Ldoppea/enlarger-electronic-timer/electronic/README.md

# Electronic for enlarger-electronic-timer

## Resources

Arduino Mini library downloaded from http://kicadhowto.org/LibLib.htm
