Ldoppea/enlarger-electronic-timer/mechanic/boxing.SLDASM

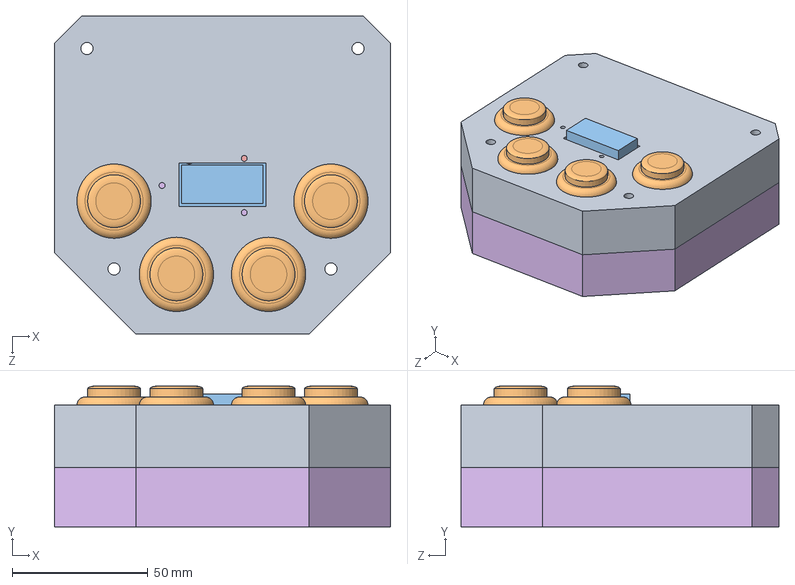
[picture p1: CAD file, 2019-05-01]
mechanic/boxing.SLDASM
124.0 x 52.0 x 117.3 mm
boxing-top
ArcadeButton^boxing x 4
GrouveDisplay^boxing
GrouveRelay^boxing
Timer^boxing
boxing-bottom
