Ldoppea/enlarger-electronic-timer/mechanic/boxing-top.sldprt

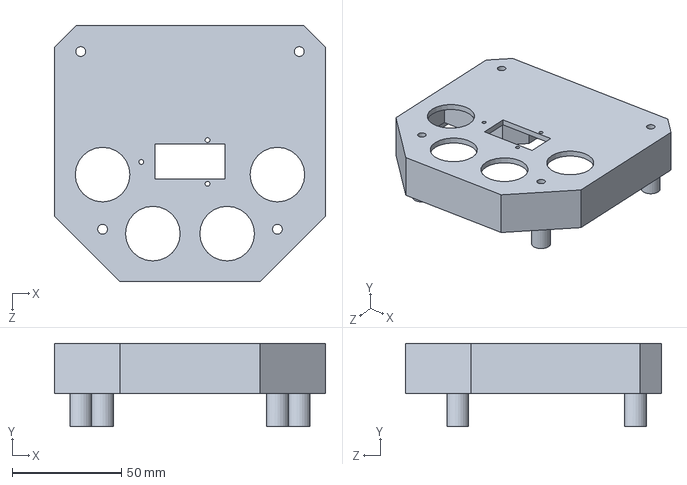
[picture p2: CAD file, 2019-05-01]
mechanic/boxing-top.sldprt
124.0 x 38.0 x 117.3 mm
