Ldoppea/enlarger-electronic-timer/mechanic/boxing-bottom.sldprt

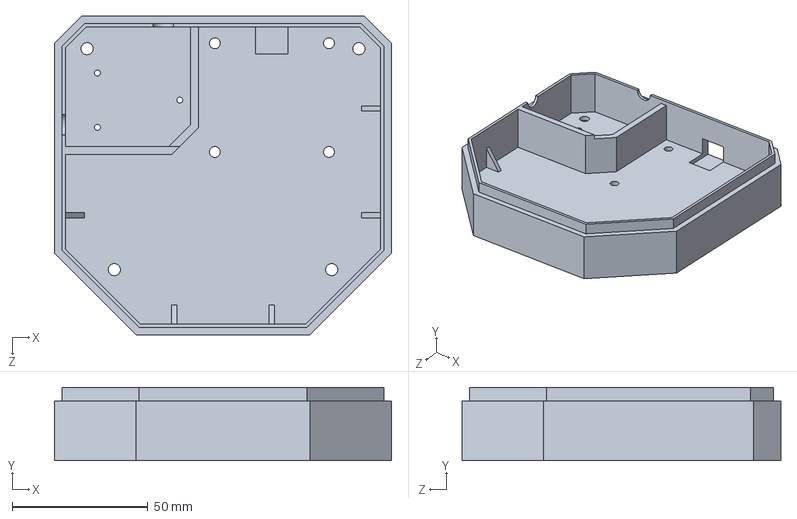
[picture p3: CAD file, 2019-05-01]
mechanic/boxing-bottom.sldprt
124.0 x 27.0 x 117.3 mm
