Ldoppea/enlarger-electronic-timer/electronic/gerber/pdf/enlarger-electronic-timer-B.Cu.pdf

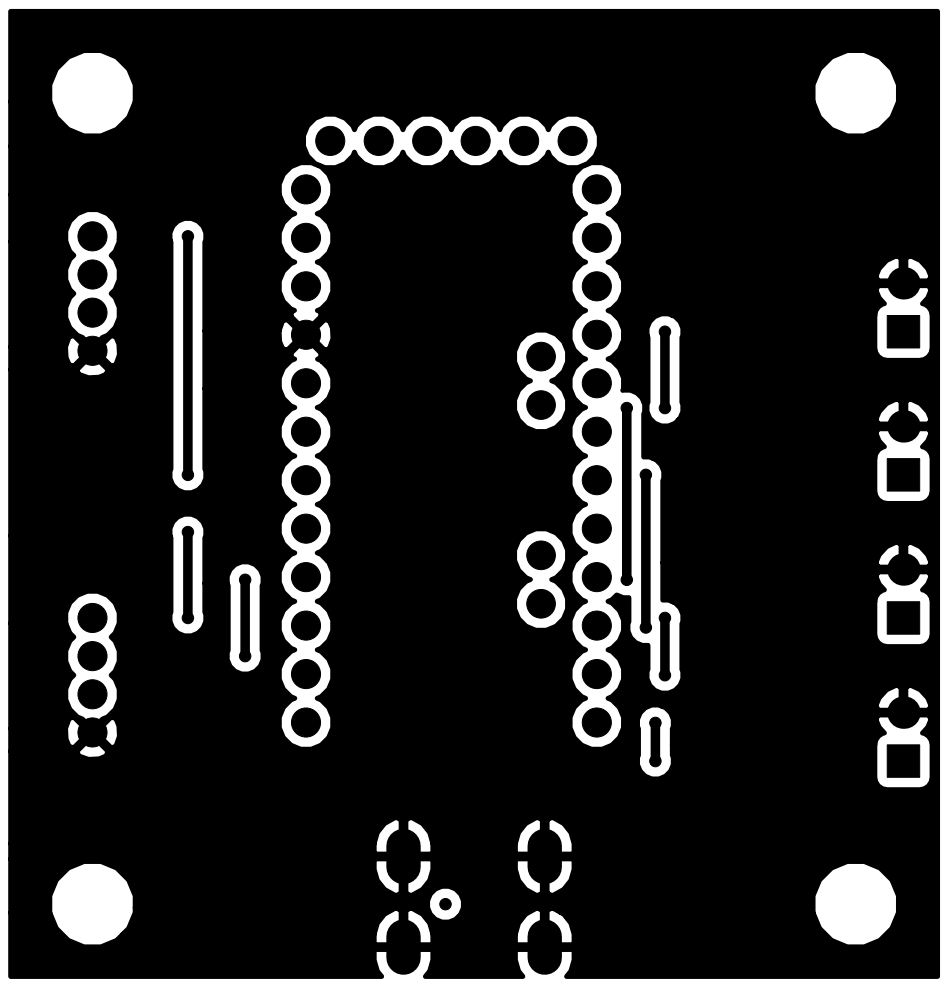
[picture p4: page 1]
