Ldoppea/enlarger-electronic-timer/electronic/gerber/pdf/enlarger-electronic-timer-B.Mask.pdf

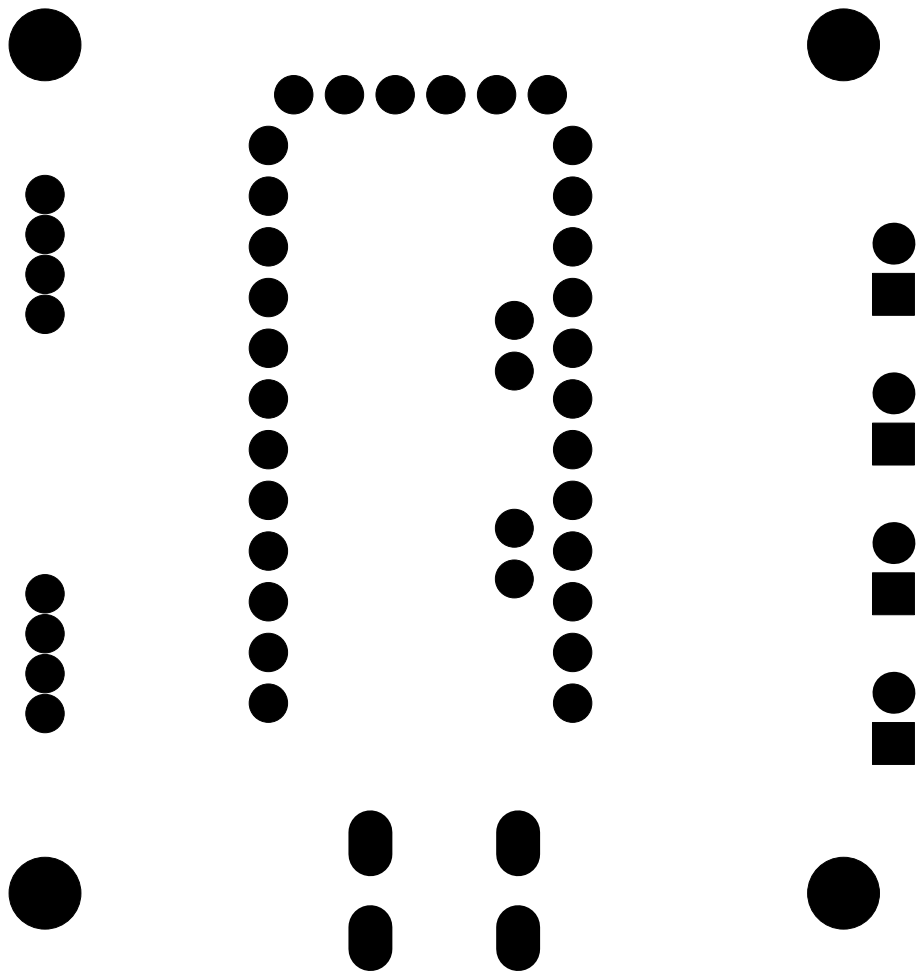
[picture p5: page 1]
