Ldoppea/enlarger-electronic-timer/electronic/gerber/pdf/enlarger-electronic-timer-F.Cu.pdf

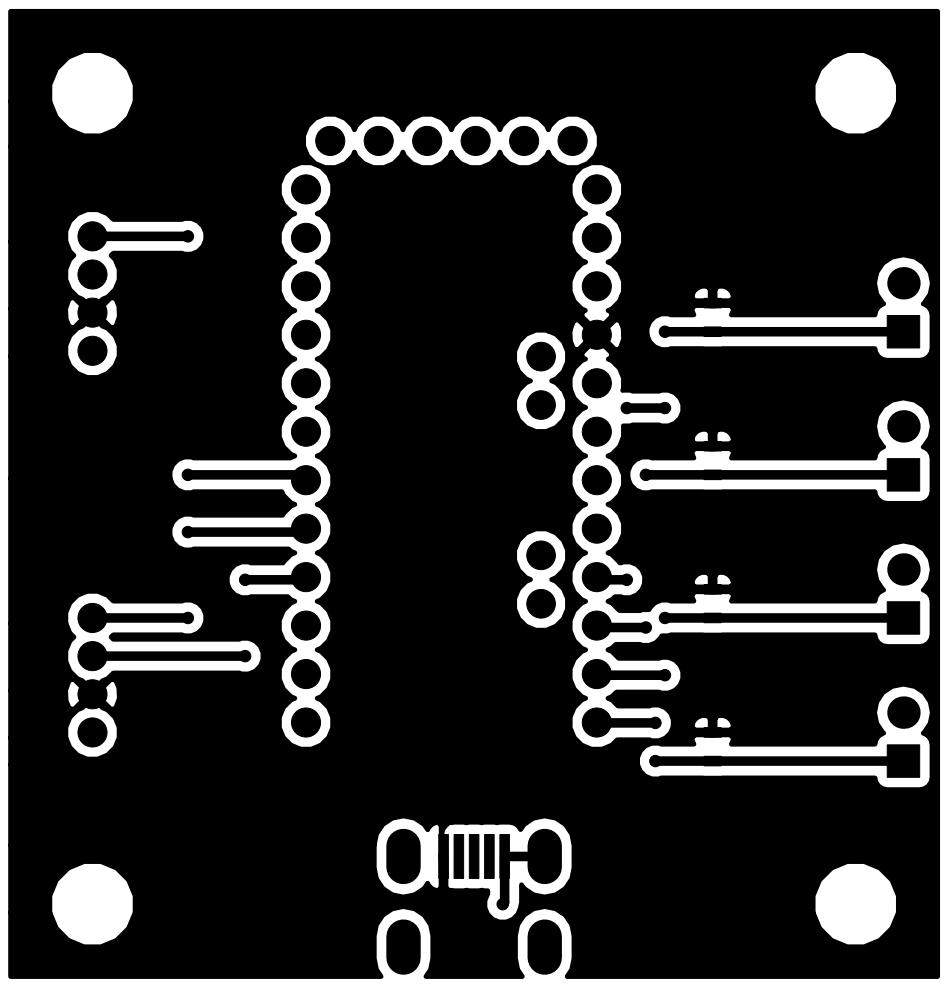
[picture p6: page 1]
