Ldoppea/enlarger-electronic-timer/electronic/gerber/pdf/enlarger-electronic-timer-F.Mask.pdf

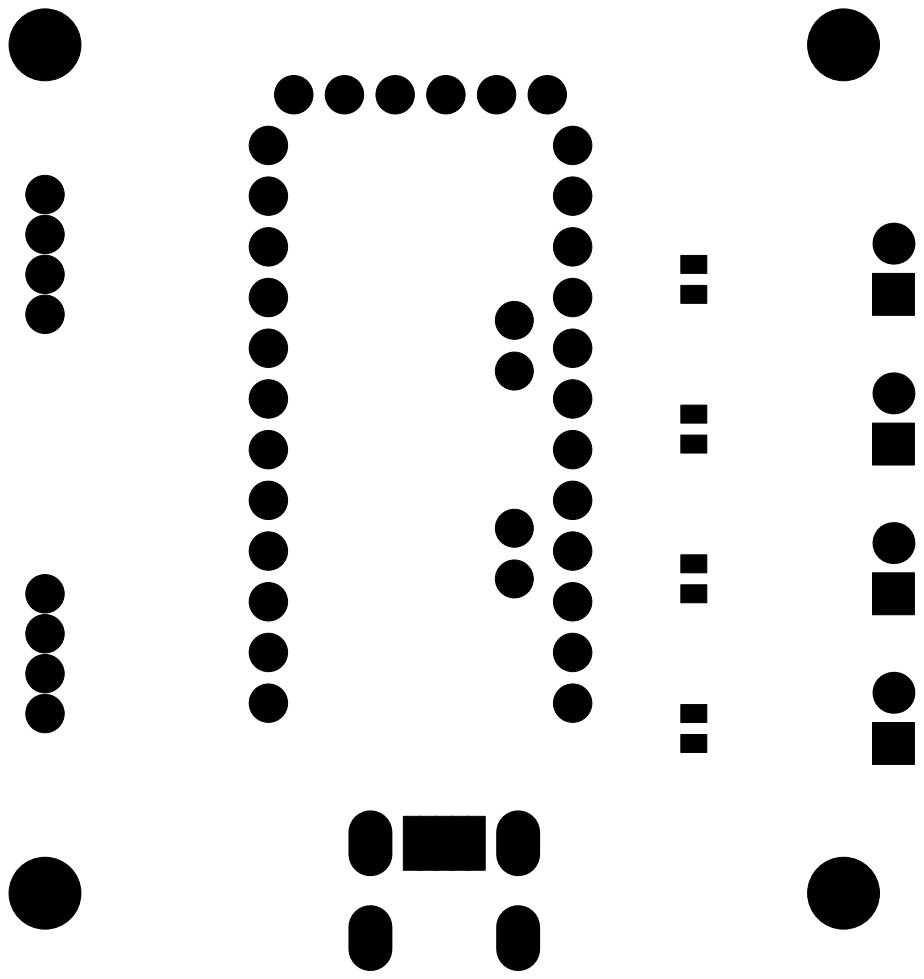
[picture p7: page 1]
