Ldoppea/enlarger-electronic-timer/electronic/gerber/pdf/enlarger-electronic-timer-F.SilkS.pdf

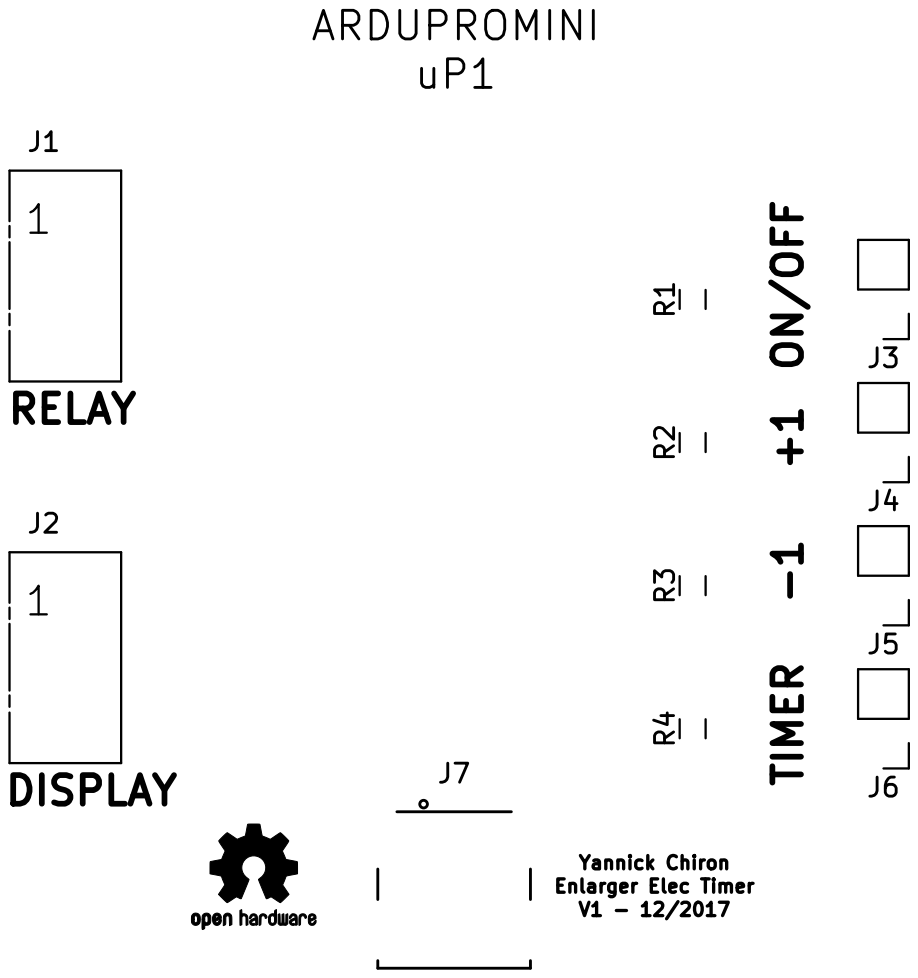
[picture p8: page 1]
