Ldoppea/enlarger-electronic-timer/electronic/enlarger-electronic-timer.kicad_pcb

## KiCad design electronic/enlarger-electronic-timer.kicad_pcb (2017-12-17)

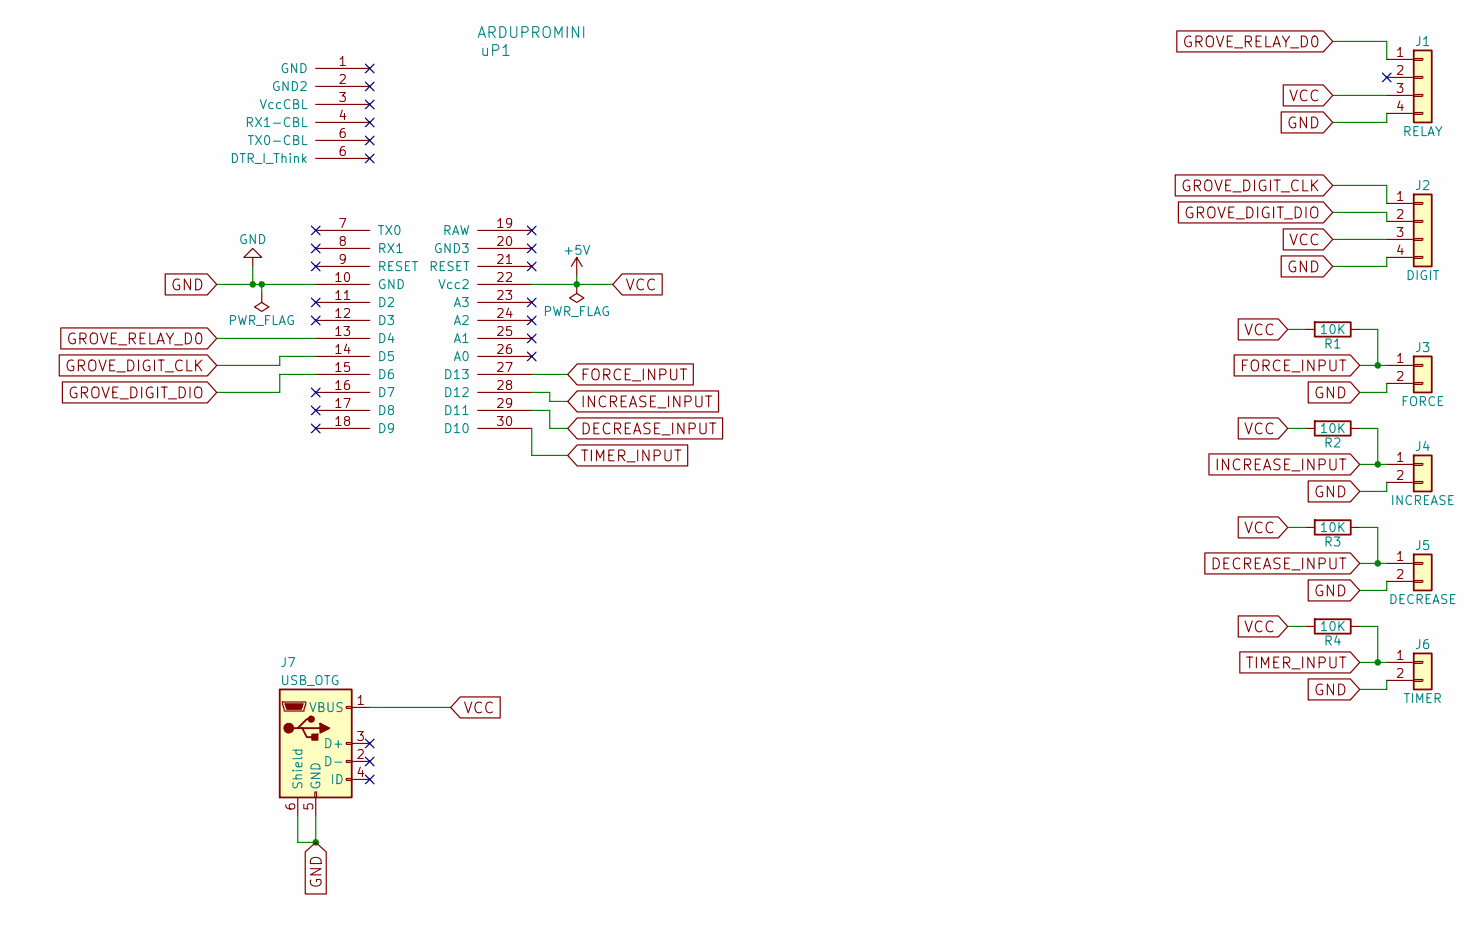
[picture p9: schematic enlarger-electronic-timer.sch]

Parts:
J1: RELAY; Grove_1x04
J2: DIGIT; Grove_1x04
J3: FORCE; Pin_Header_Straight_1x02_Pitch2.54mm
J4: INCREASE; Pin_Header_Straight_1x02_Pitch2.54mm
J5: DECREASE; Pin_Header_Straight_1x02_Pitch2.54mm
J6: TIMER; Pin_Header_Straight_1x02_Pitch2.54mm
J7: USB_OTG; ST-USB-013A
R1, R2, R3, R4: 10K; R_0603
uP1: ARDUPROMINI; arduino_mini

Connections:
DECREASE_INPUT: J5.1, R3.1, uP1.29 (D11)
FORCE_INPUT: J3.1, R1.1, uP1.27 (D13)
GND: J1.4, J2.4, J3.2, J4.2, J5.2, J6.2, J7.5 (GND), J7.6 (Shield), uP1.10 (GND)
GROVE_DIGIT_CLK: J2.1, uP1.14 (D5)
GROVE_DIGIT_DIO: J2.2, uP1.15 (D6)
GROVE_RELAY_D0: J1.1, uP1.13 (D4)
INCREASE_INPUT: J4.1, R2.1, uP1.28 (D12)
TIMER_INPUT: J6.1, R4.1, uP1.30 (D10)
VCC: J1.3, J2.3, J7.1 (VBUS), R1.2, R2.2, R3.2, R4.2, uP1.22 (Vcc2)

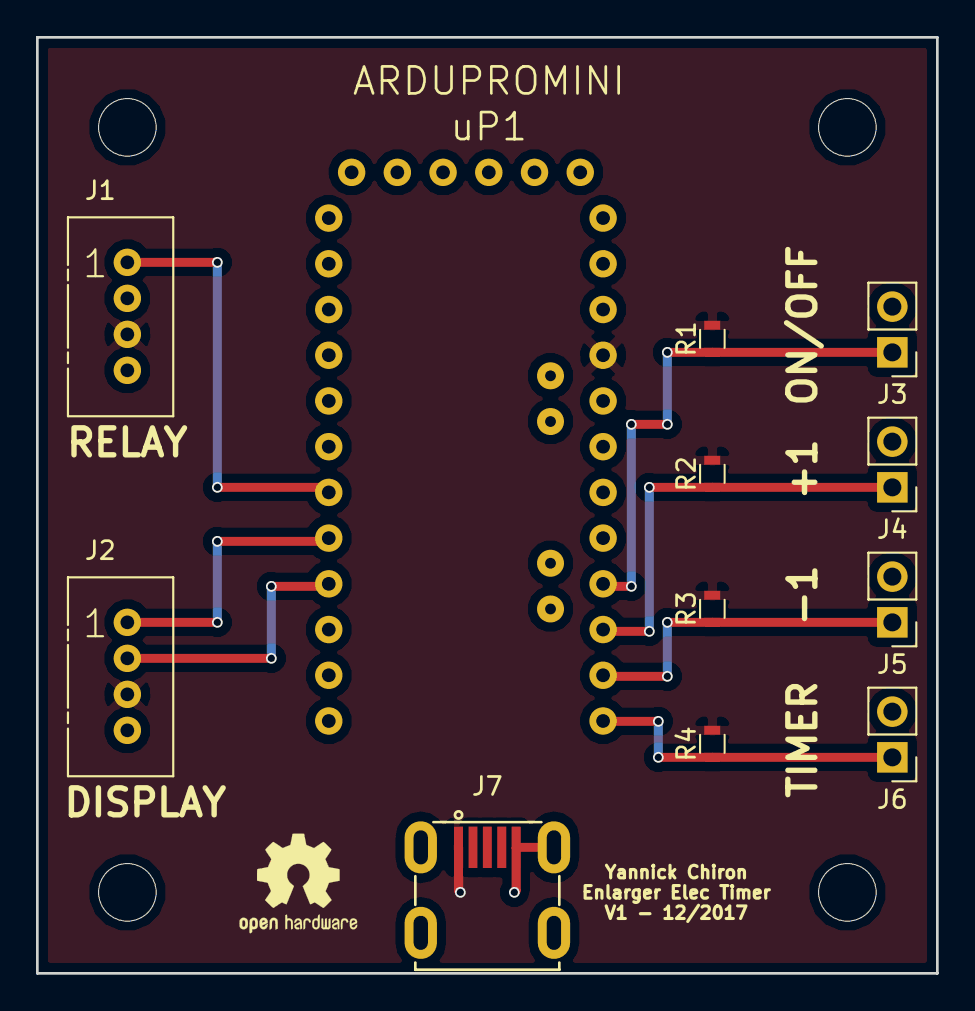
[picture p10: board enlarger-electronic-timer.kicad_pcb from above]

Board: 2 copper layers, 50.0 x 52.0 mm, 12 parts (0 on the bottom side), 9 nets.
