Ldoppea/enlarger-electronic-timer/(commit log)

2017-12-16 Added Arduino Mini library
    [enlarger-electronic-timer.kicad_pcb, enlarger-electronic-timer.sch]
2017-12-16 Fixed arduino library power pins, added grov connectors for relay/digits
    [enlarger-electronic-timer.sch]
2017-12-16 Added buttons, USB. placed components on PCB
    [enlarger-electronic-timer.kicad_pcb, enlarger-electronic-timer.sch]
2017-12-16 Wired pcb
    [enlarger-electronic-timer.kicad_pcb]
2017-12-16 Added dimensions
    [enlarger-electronic-timer.kicad_pcb]
2017-12-17 Added link between USB GND pin and GND holes.
    [enlarger-electronic-timer.kicad_pcb]
2017-12-17 Updated plot with latest changes
    [enlarger-electronic-timer-B.Cu.gbl, enlarger-electronic-timer-B.Mask.gbs, enlarger-electronic-timer-B.SilkS.gbo, enlarger-electronic-timer-Edge.Cuts.gm1, enlarger-electronic-timer-F.Cu.gtl, enlarger-electronic-timer-F.Mask.gts, enlarger-electronic-timer-F.SilkS.gto, enlarger-electronic-timer.drl]
2017-12-17 Added OSHW loto and PCB name. Updated plot with latest changes
    [enlarger-electronic-timer-B.Cu.gbl, enlarger-electronic-timer-B.Mask.gbs, enlarger-electronic-timer-B.SilkS.gbo, enlarger-electronic-timer-Edge.Cuts.gm1, enlarger-electronic-timer-F.Cu.gtl, enlarger-electronic-timer-F.Mask.gts, enlarger-electronic-timer-F.SilkS.gto, enlarger-electronic-timer.drl]
2019-04-10 Add CAD file for box 3D printing
    [boxing.SLDASM]
2019-04-19 Increase M4 nuts sizes
    [boxing.SLDASM]
2019-05-01 Decrease boxing size to fit 3D printer limitations
    [boxing.SLDASM]
2019-05-01 Move top and bottom boxing into external sldprt files
    [boxing-bottom.sldprt, boxing-top.sldprt, boxing.SLDASM]
2019-06-02 Add first draft for Arduino program
2019-06-02 Update timer to handle 2 different speeds
2019-06-03 Add timer run/pause/stop states
